ECE411PracticumTeam1/ECE411_PracticumProject_Team1/ECE411_Prototype/IMG_20221023_162744.jpg

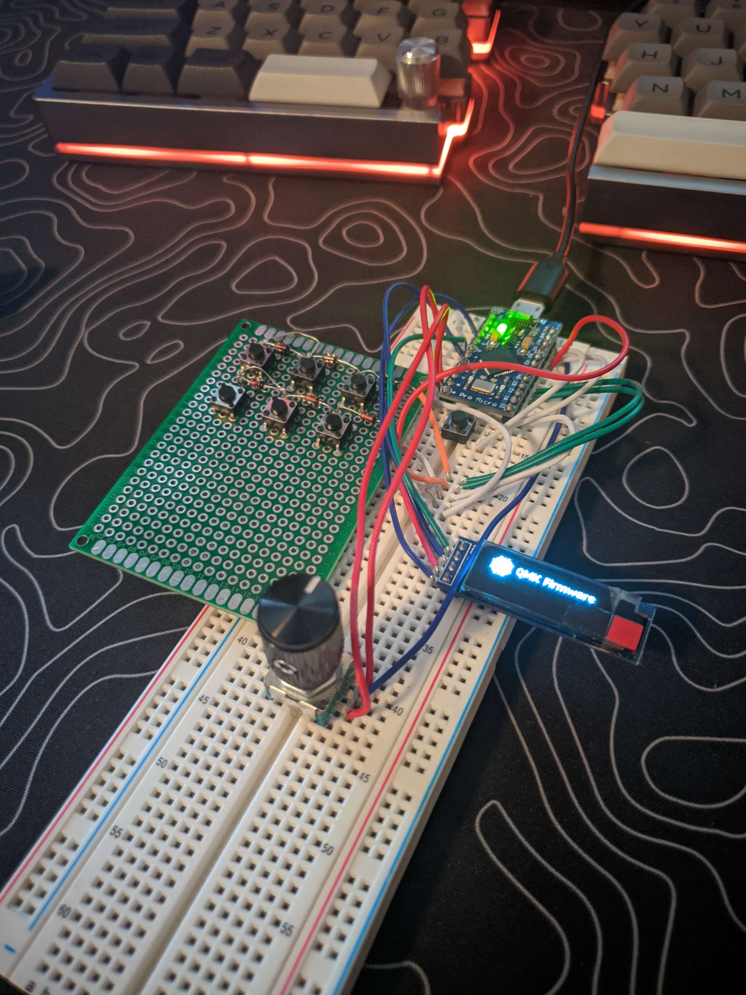
ECE411_Prototype/IMG_20221023_162744.jpg
