ECE411PracticumTeam1/ECE411_PracticumProject_Team1/README.md

# ECE411-Practicum Project
This is the repository for our programmable keyboard macropad. It houses all our schematics, case and pcb designs, code, and documentations.
