ECE411PracticumTeam1/ECE411_PracticumProject_Team1/Documents/Team1ProjSchedule.pdf

Team 1 Gannt Chart | Oct 31, 2022 http://

Project manager
Project dates | Oct 31, 2022 - Dec 10, 2022
Completion | 9%
Tasks | 14
Resources | 4

Name | Begin date | End date
Prototyping | 10/31/22 | 11/3/22
Schematic | 10/31/22 | 11/3/22
Preliminary Layout | 10/31/22 | 11/3/22
BOM | 11/4/22 | 11/10/22
CAD Rough Draft | 11/4/22 | 11/10/22
Functional Decomposition | 11/4/22 | 11/10/22
Finalize CAD | 11/4/22 | 11/15/22
Design Review Fix | 11/11/22 | 11/15/22
Send Board to Fab | 11/16/22 | 11/17/22
Design Housing | 11/17/22 | 11/23/22
Create Housing | 11/23/22 | 11/30/22
Testing | 12/1/22 | 12/8/22
Prepare Presentation/Demos | 12/1/22 | 12/8/22
Demo Day! | 12/9/22 | 12/9/22
Team 1 Gannt Chart | Oct 31, 2022
Tasks | 2

Name | Default role
David Dinh | developer
Johnathan Cruz | developer
Danny Tran | developer
David Brown | developer

## Resources

3

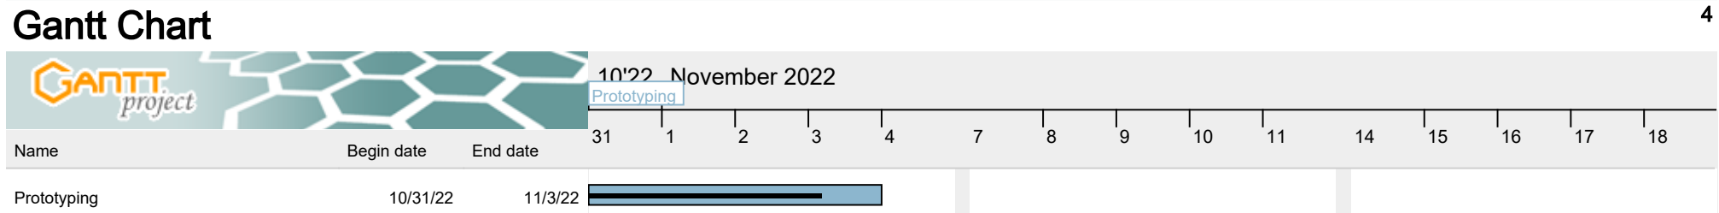
[picture p3: figure]
Gantt Chart; Name; Begin date; End date; Prototyping; 10'22 November 2022

Schematic | 10/31/22 | 11/3/22
Preliminary Layout | 10/31/22 | 11/3/22
BOM | 11/4/22 | 11/10/22
CAD Rough Draft | 11/4/22 | 11/10/22
Functional Decomposition | 11/4/22 | 11/10/22
Finalize CAD | 11/4/22 | 11/15/22
Design Review Fix | 11/11/22 | 11/15/22
Send Board to Fab | 11/16/22 | 11/17/22
Design Housing | 11/17/22 | 11/23/22
Create Housing | 11/23/22 | 11/30/22
Testing | 12/1/22 | 12/8/22
Prepare Presentation/Demos | 12/1/22 | 12/8/22
Demo Day! | 12/9/22 | 12/9/22
