ECE411PracticumTeam1/ECE411_PracticumProject_Team1/Documents/ECE411_Team_1_PDS/ECE411_Team_1_PDS-1.png

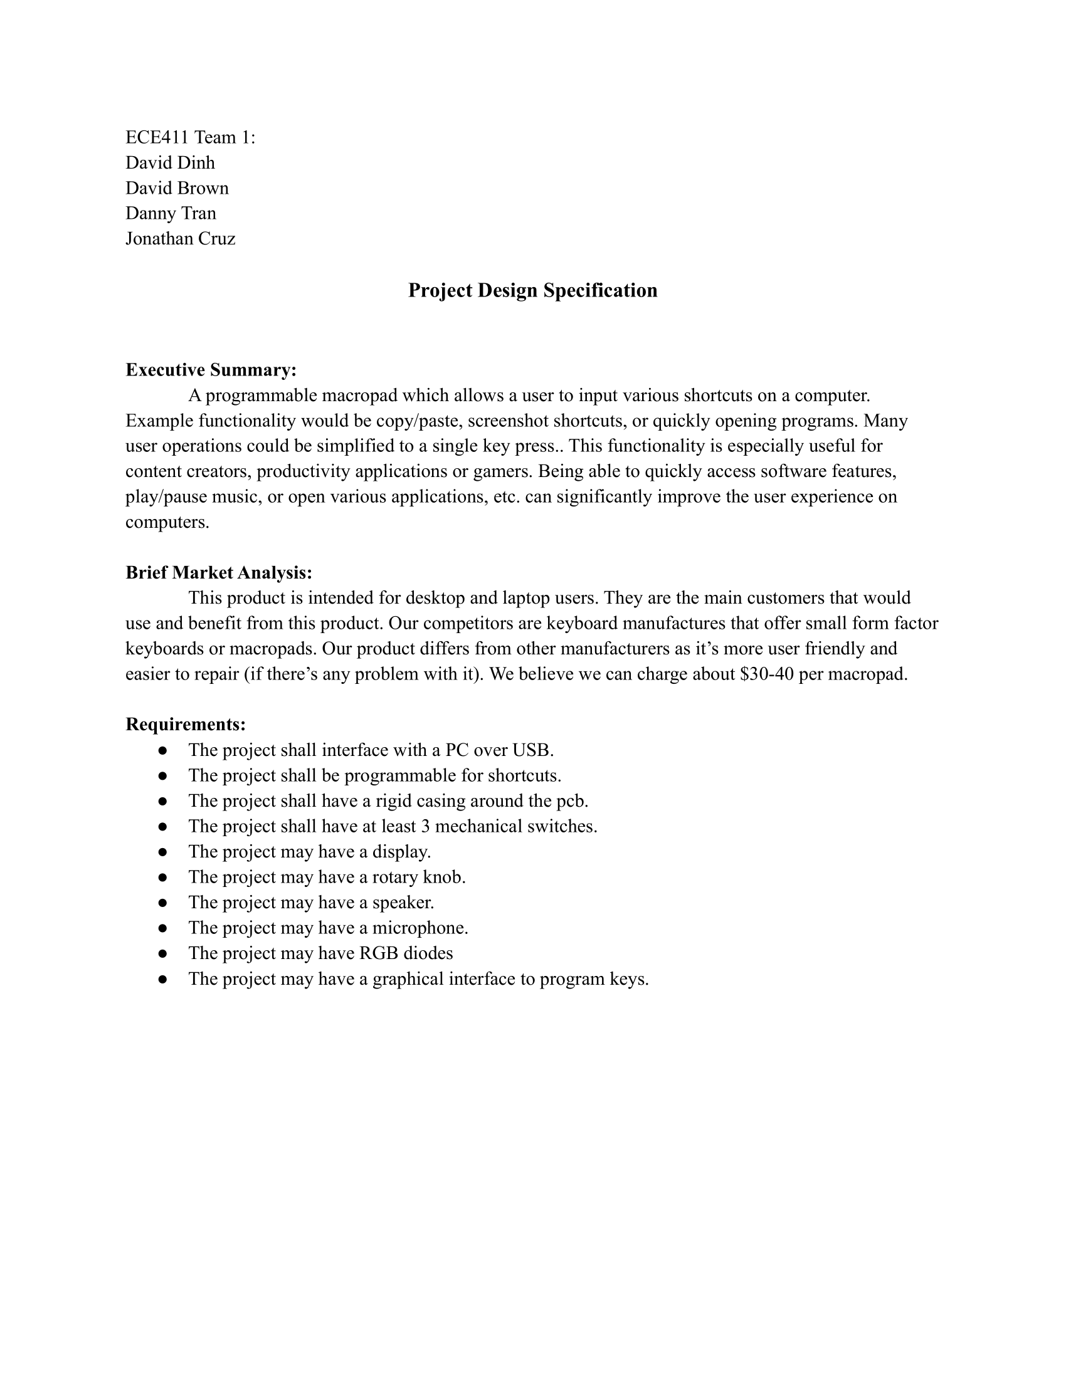
Documents/ECE411_Team_1_PDS/ECE411_Team_1_PDS-1.png
