ECE411PracticumTeam1/ECE411_PracticumProject_Team1/Functional_Decomposition/Functional Decomposition Level 0.png

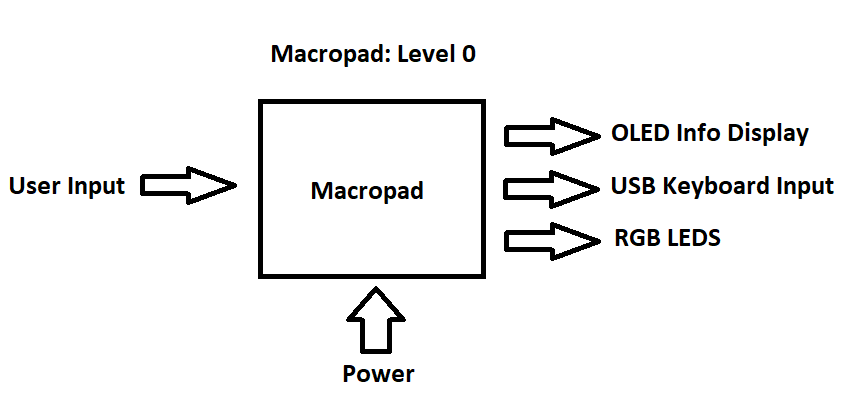
Functional_Decomposition/Functional Decomposition Level 0.png
