ECE411PracticumTeam1/ECE411_PracticumProject_Team1/Documents/Team_1_BOM.xlsx

Bill Of Materials for: [TEAM 1] [Team D3onathon]
Last modified: [11/9/2022]
PCB version: 1.0
BOM revision: A |  | P/NP | Place/Not Place (components marked NP are not stuffed on the board)
Count | Part References | P/NP | Mfg | Mfg PN | Description | Dist | Dist Part Number | Cost Ea. | Cost Total
30 | C1, C2, C3, C4, C5, C6 | P | KEMET | C0402C104K4PAC7867 | 0.1uF Ceramic Capacitor | Digikey (https://www.digikey.com/en/products/detail/kemet/C0402C104K4PAC7867/2196232) | 399-C0402C104K4PAC7867TR-ND | $0.10 | $3.00
100 | D1, D2, D3, D4, D5, D6 | P | Bridgold | bg-195 | DIODE | Amazon (https://www.amazon.com/Bridgold-1N4148W-High-Speed-Switching-SOD-123/dp/B09TKVYJL6) | B09TKVYJL6 | $0.08 | $8.00
20 | D7, D8, D9, D10, D11, D12 | P | DIYmall | WS2812B | LEDs | Amazon (https://www.amazon.com/DIYmall-WS2812B-Built-Programmable-Arduino/dp/B0B1MC997K) | B0B1MC997K | $0.40 | $8.00
5 | OL1 | P | Frienda | Frienda-d'Affichage-02 | OLED | Amazon (https://www.amazon.com/Pieces-Display-Module-SSD1306-3-3V-5V/dp/B08CDN5PSJ) | B08CDN5PSJ | $3.50 | $17.50
50 | R1 | P | YAGEO | RT0603FRE134K7L | 4.7k Chip Resistor | Digikey (https://www.digikey.com/en/products/detail/yageo/RT0603FRE134K7L/14286835) | 13-RT0603FRE134K7LTR-ND | $0.06 | $2.95
10 | SW1 | P | Omron Electronics Inc-EMC | B3F-1020 | RST Pin | Digikey (https://www.digikey.com/en/products/detail/omron-electronics-inc-emc-div/B3F-1020/44059) | SW402-ND | $0.38 | $3.80
70 | SW2, SW3, SW4, SW5, SW6, SW7 | P | N\C | N/A | SW_Push | Amazon (https://www.amazon.com/Gateron-Switches-%EF%BC%8CMechanical-Keyboard-Mechanical/dp/B09JSM1911) | B09JSM1911 | $0.34 | $23.80
1 | U1 | P | Sparkfun | DEV-12640 | Sparkfun_Pro_Micro | Sparkfun (https://www.sparkfun.com/products/12640) | DEV-12640 | $19.50 | $19.50
 |  |  |  |  |  |  |  | TOTAL: | $86.55
VERSION INFO
Rev | Date | Notes
A | 2022-11-09 | Intial BOM, with Rough Draft CAD
