ECE411PracticumTeam1/ECE411_PracticumProject_Team1/ECE411_Case/frameSplit.dxf

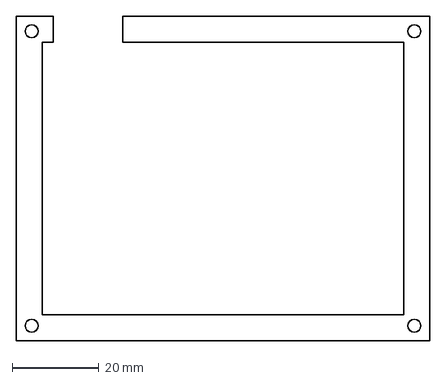
[picture p10: CAD file, 2022-12-08]
ECE411_Case/frameSplit.dxf
95.2 x 74.8 mm
