ECE411PracticumTeam1/ECE411_PracticumProject_Team1/ECE411_Case/backplate.dxf

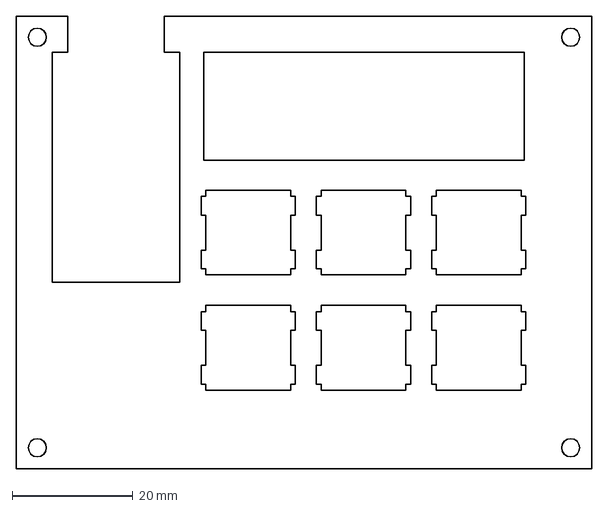
[picture p11: CAD file, 2022-12-08]
ECE411_Case/backplate.dxf
95.2 x 74.8 mm
