ECE411PracticumTeam1/ECE411_PracticumProject_Team1/Documents/Test_Plan_Team_1/Test_Plan_Team_1-1.png

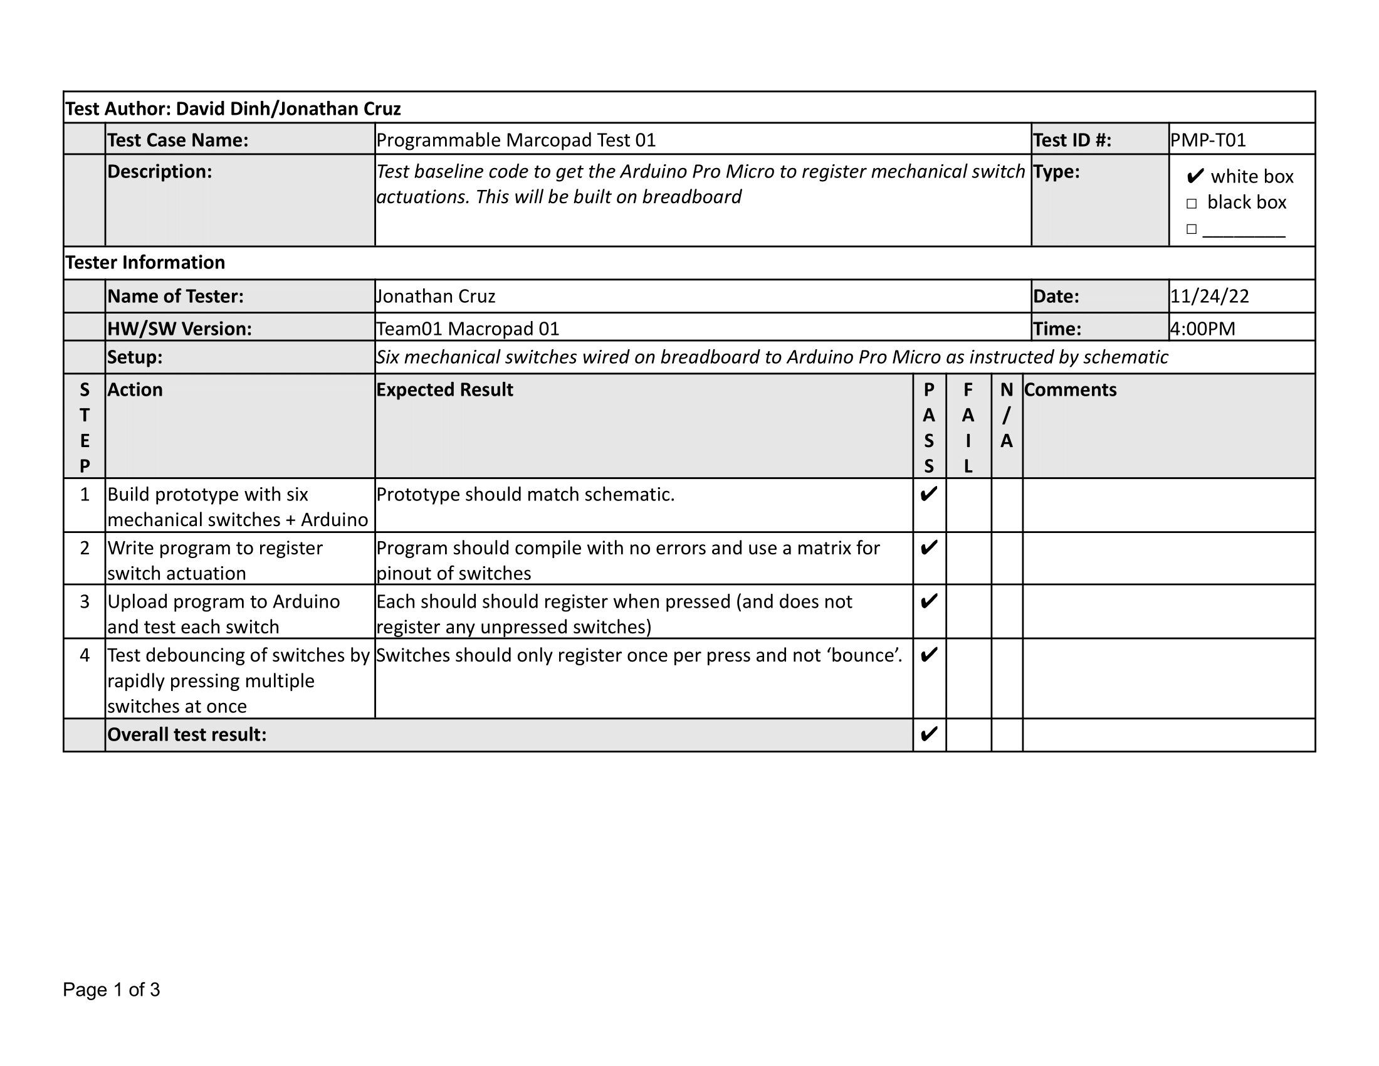
Documents/Test_Plan_Team_1/Test_Plan_Team_1-1.png
