ECE411PracticumTeam1/ECE411_PracticumProject_Team1/ECE411_Project Schematic/ECE411 Team 1 Practicum.pdf

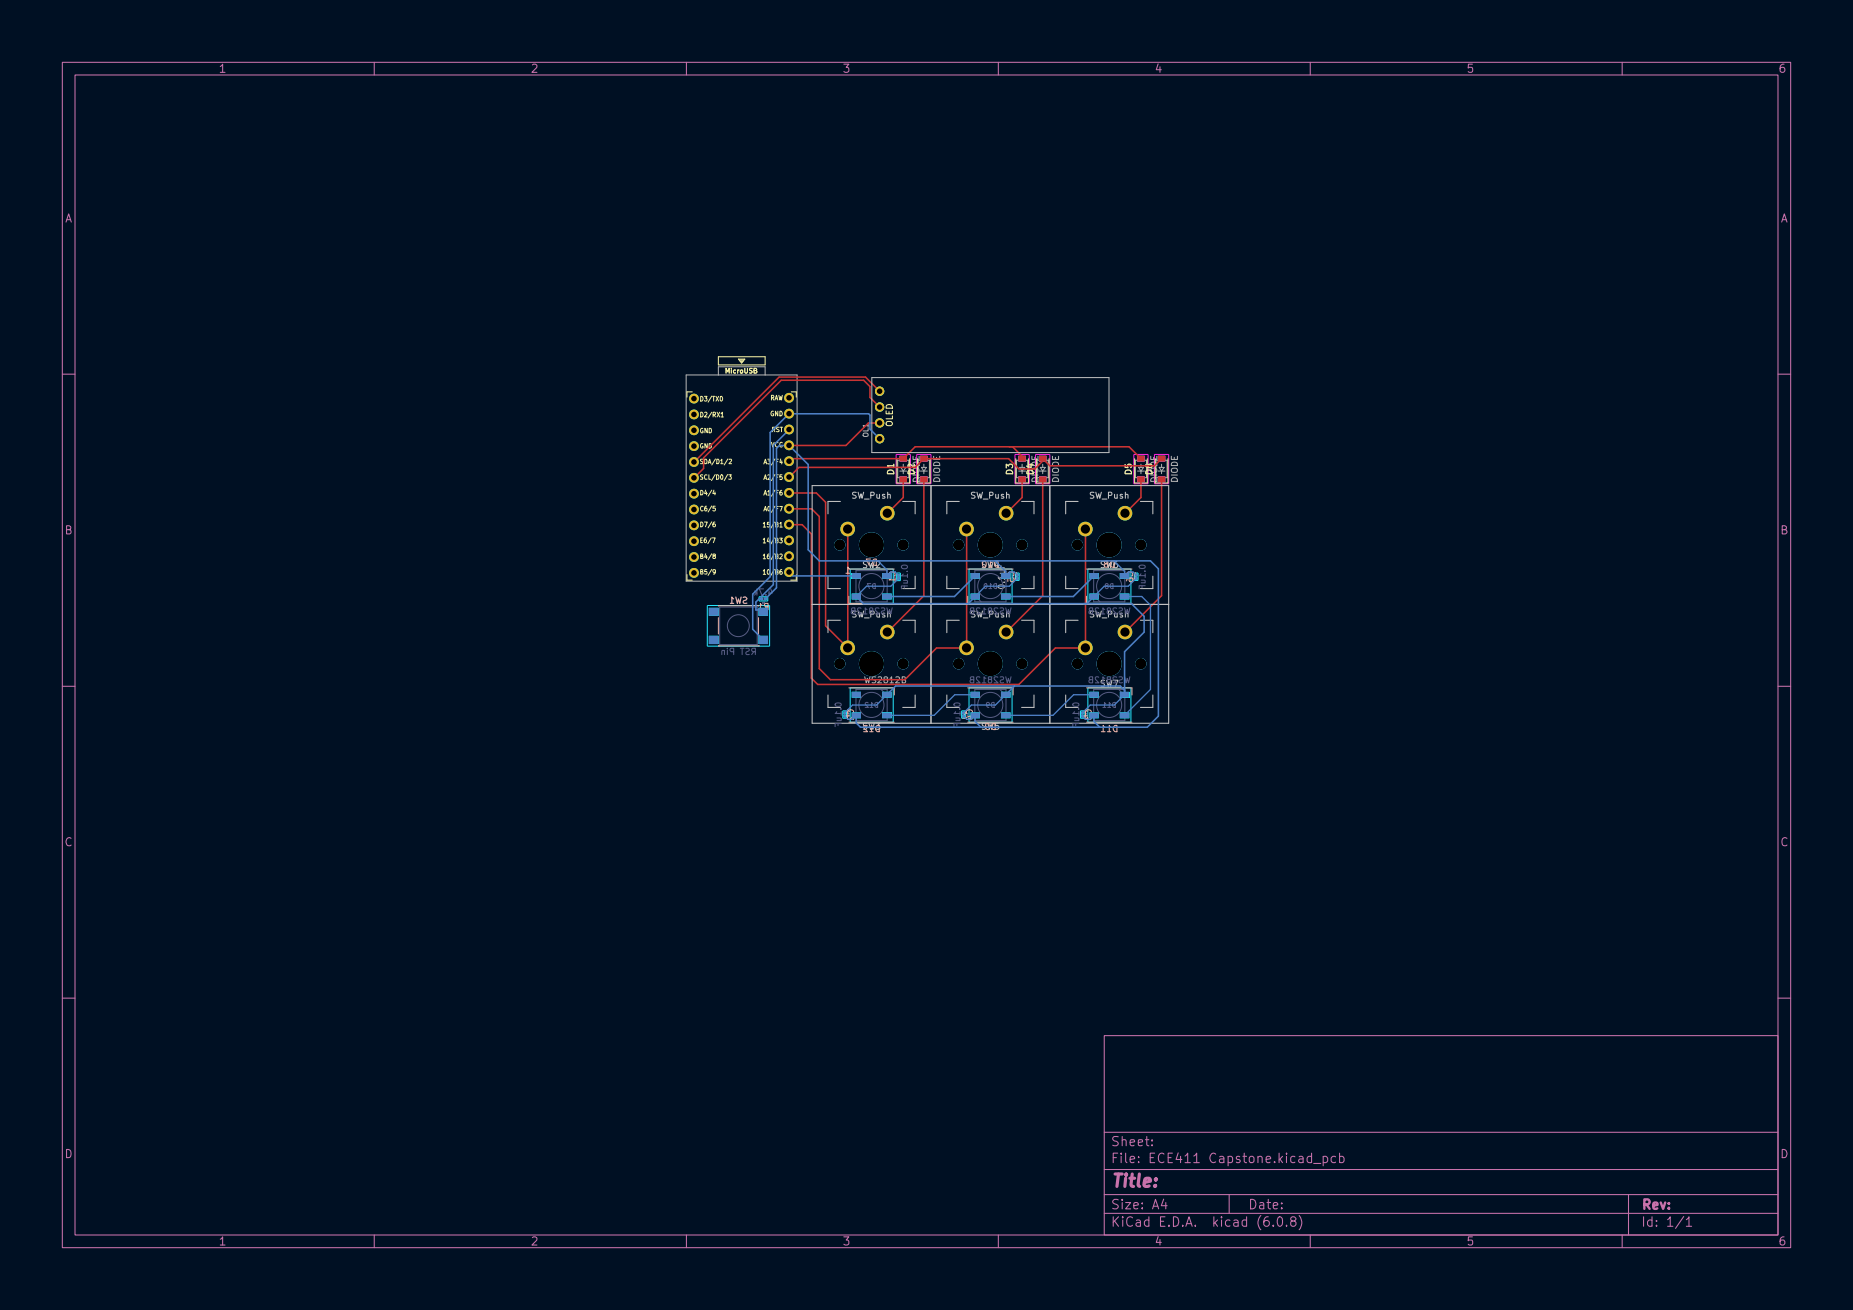
[picture p15: page 1]
