ECE411PracticumTeam1/ECE411_PracticumProject_Team1/ECE411_Project Schematic/ECE411_PracticumProject_Team1_PCB-1.pdf

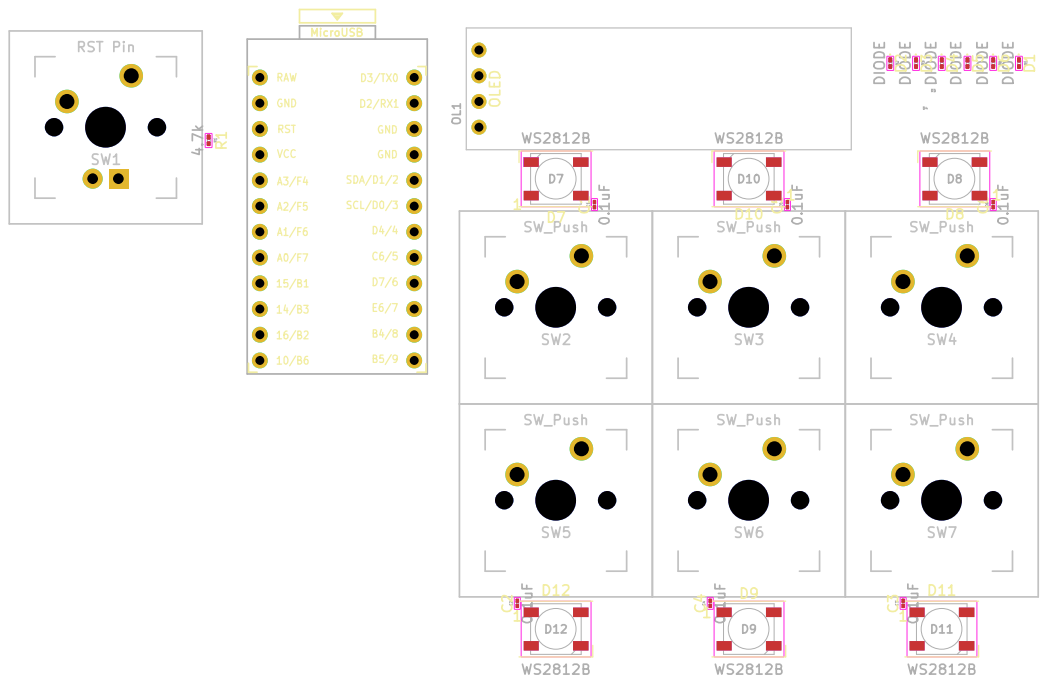
[picture p16: page 1]
