ECE411PracticumTeam1/ECE411_PracticumProject_Team1/ECE411_Project Schematic/ECE411_PracticumProject_Team1_Schematic-1.pdf

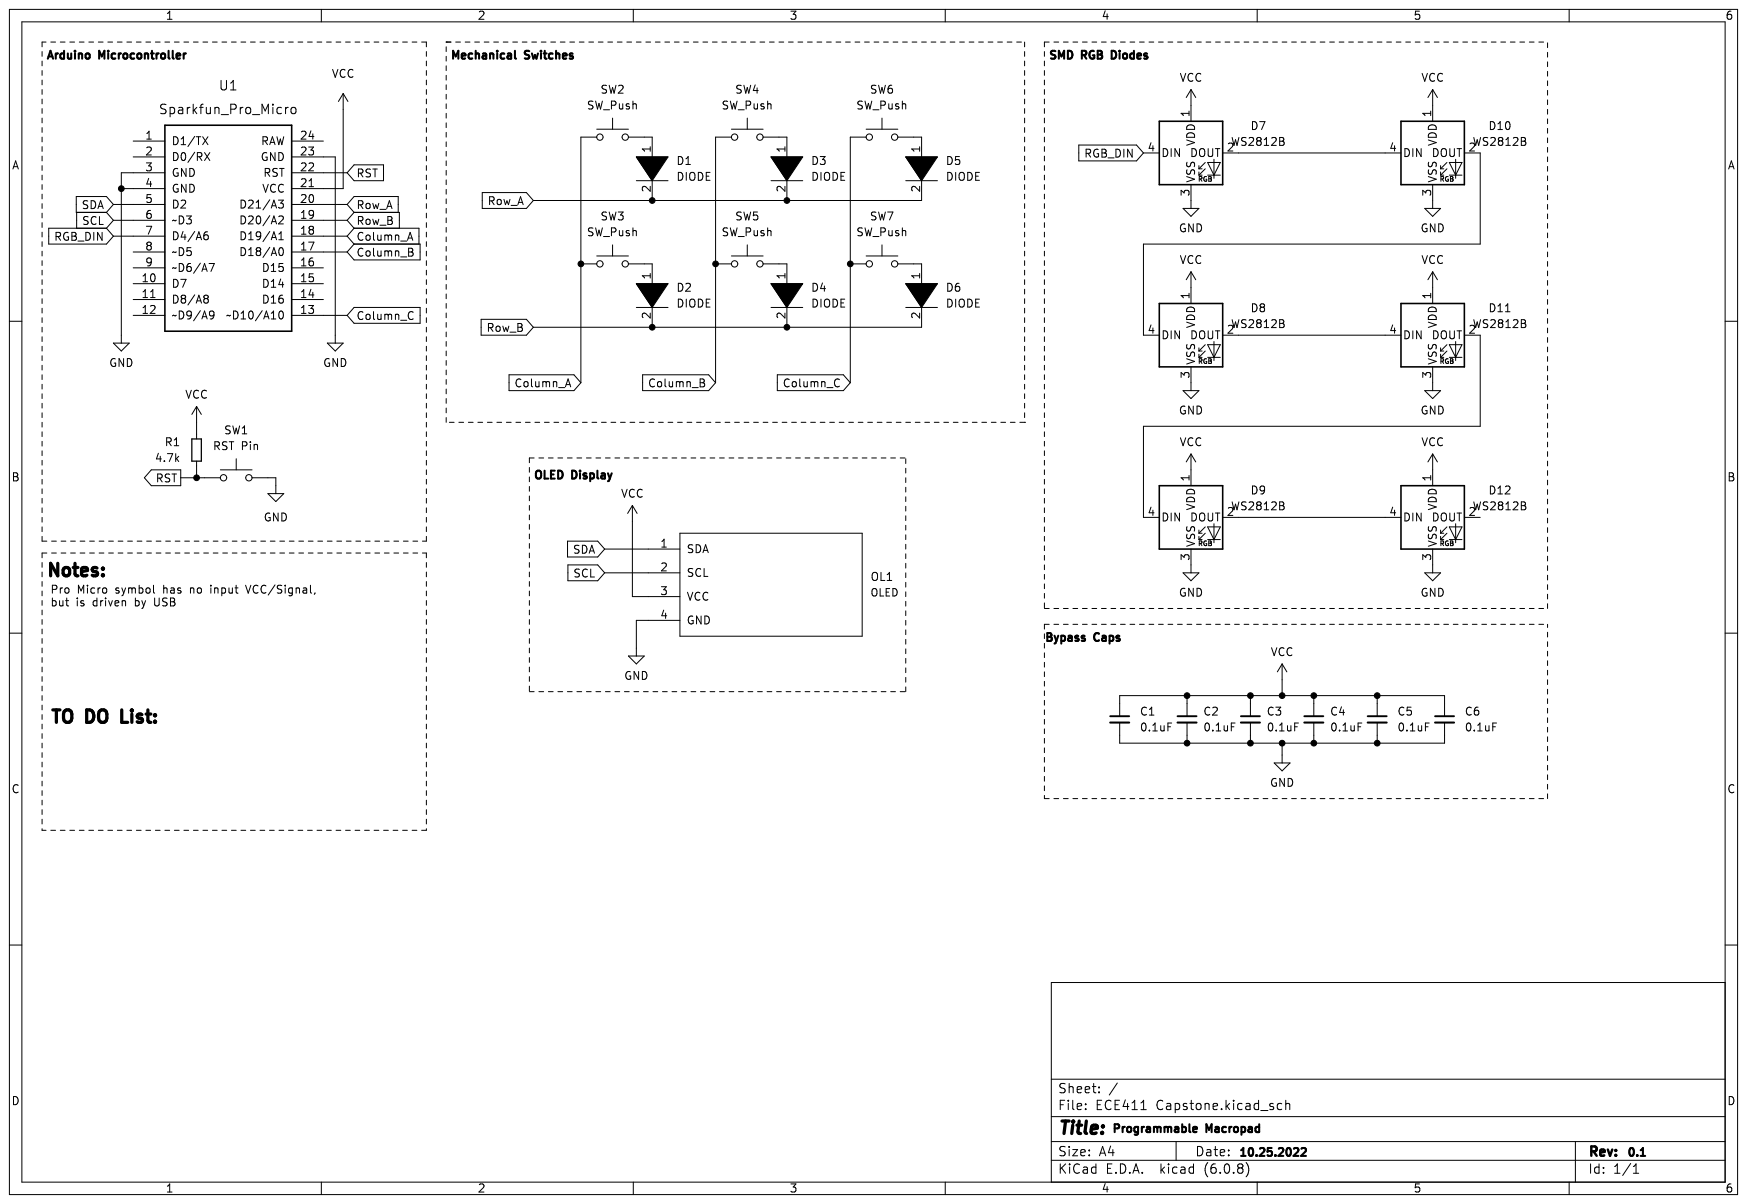
[picture p17: page 1]
