ECE411PracticumTeam1/ECE411_PracticumProject_Team1/ECE411_Layout/ECE411 Team 1 Schematic.pdf

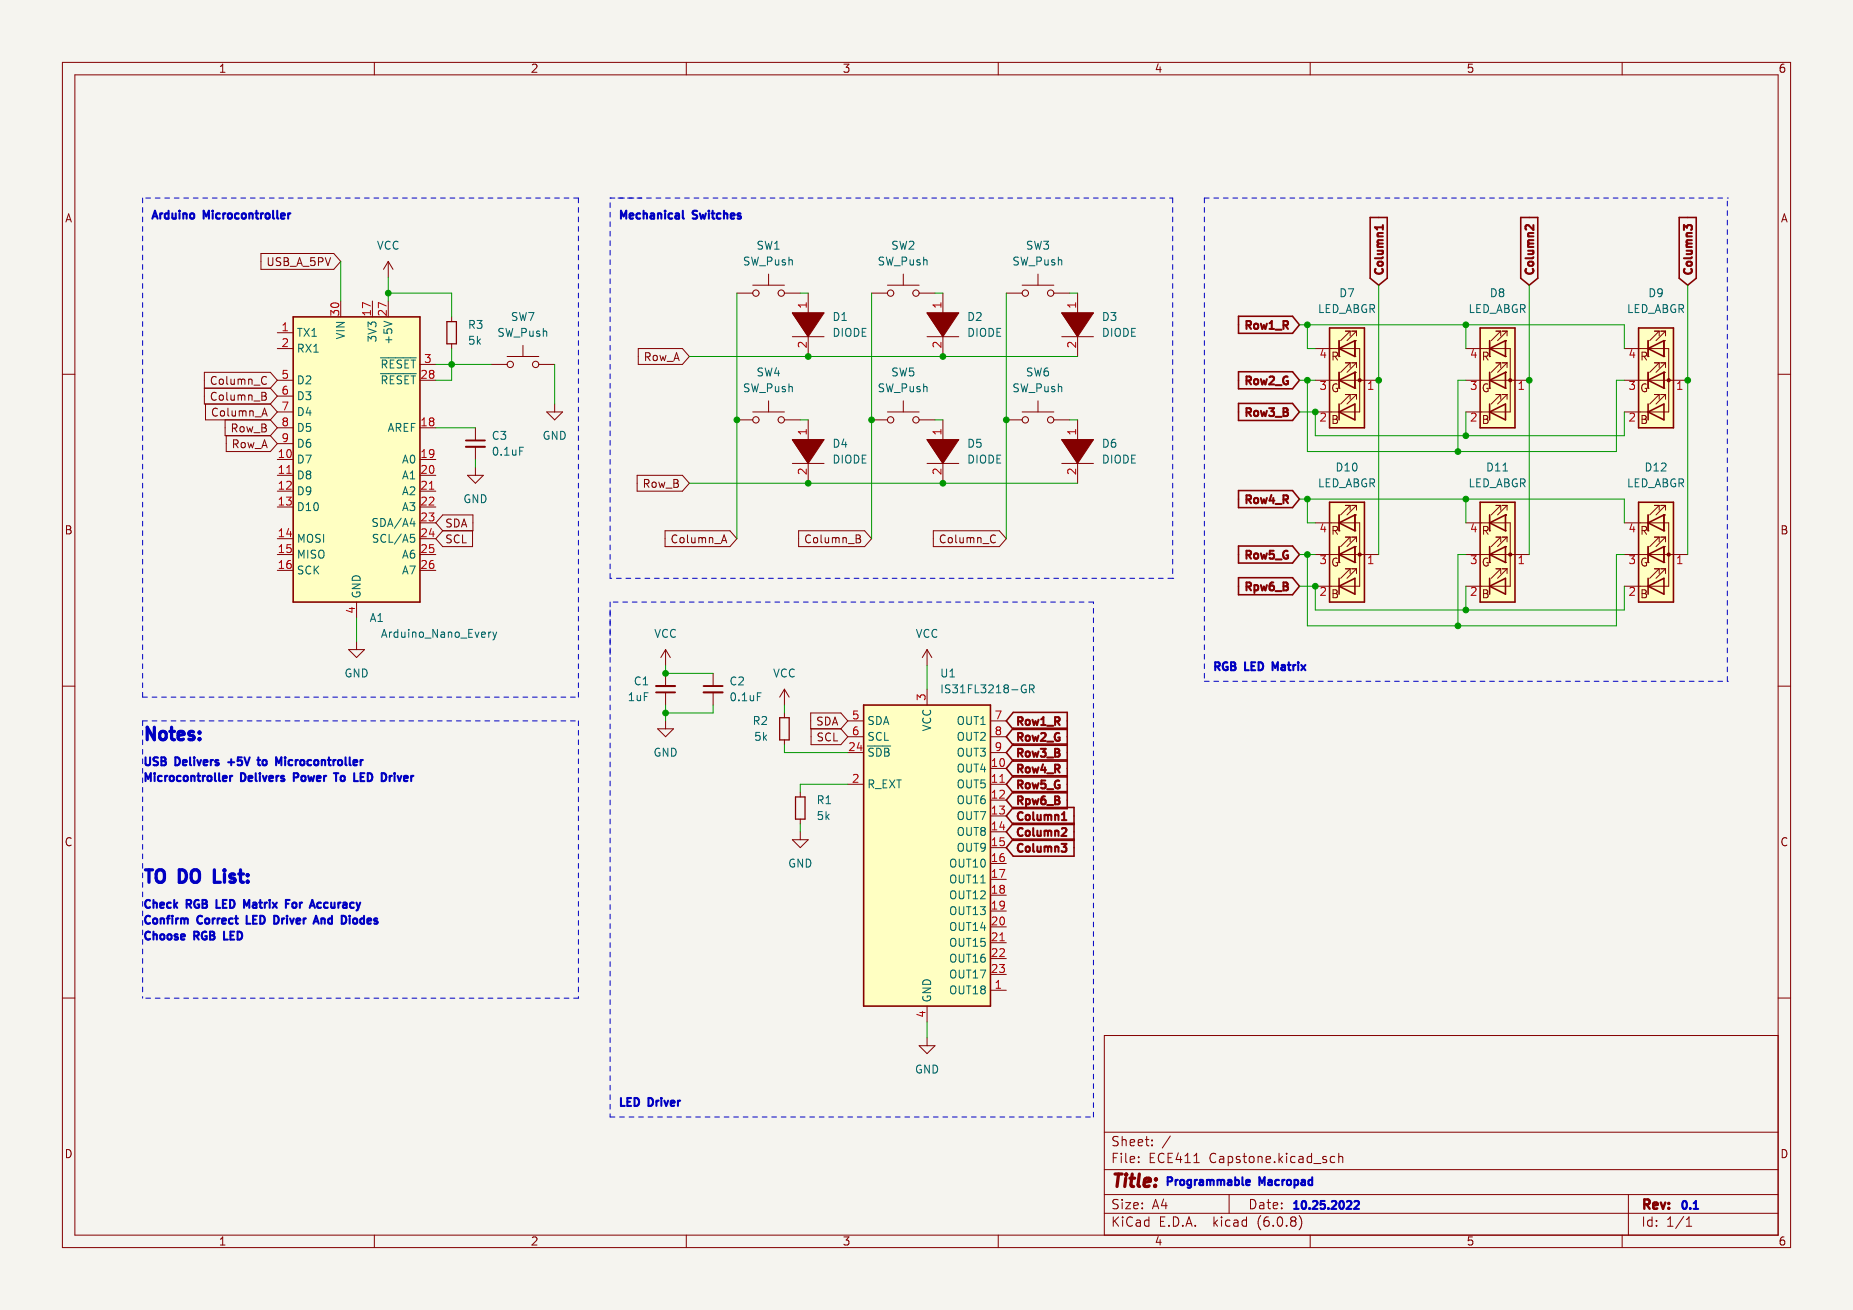
[picture p18: page 1]
