ECE411PracticumTeam1/ECE411_PracticumProject_Team1/ECE411_Layout/ECE411 Capstone.kicad_pcb

## KiCad design ECE411_Layout/ECE411 Capstone.kicad_pcb (2022-12-08)

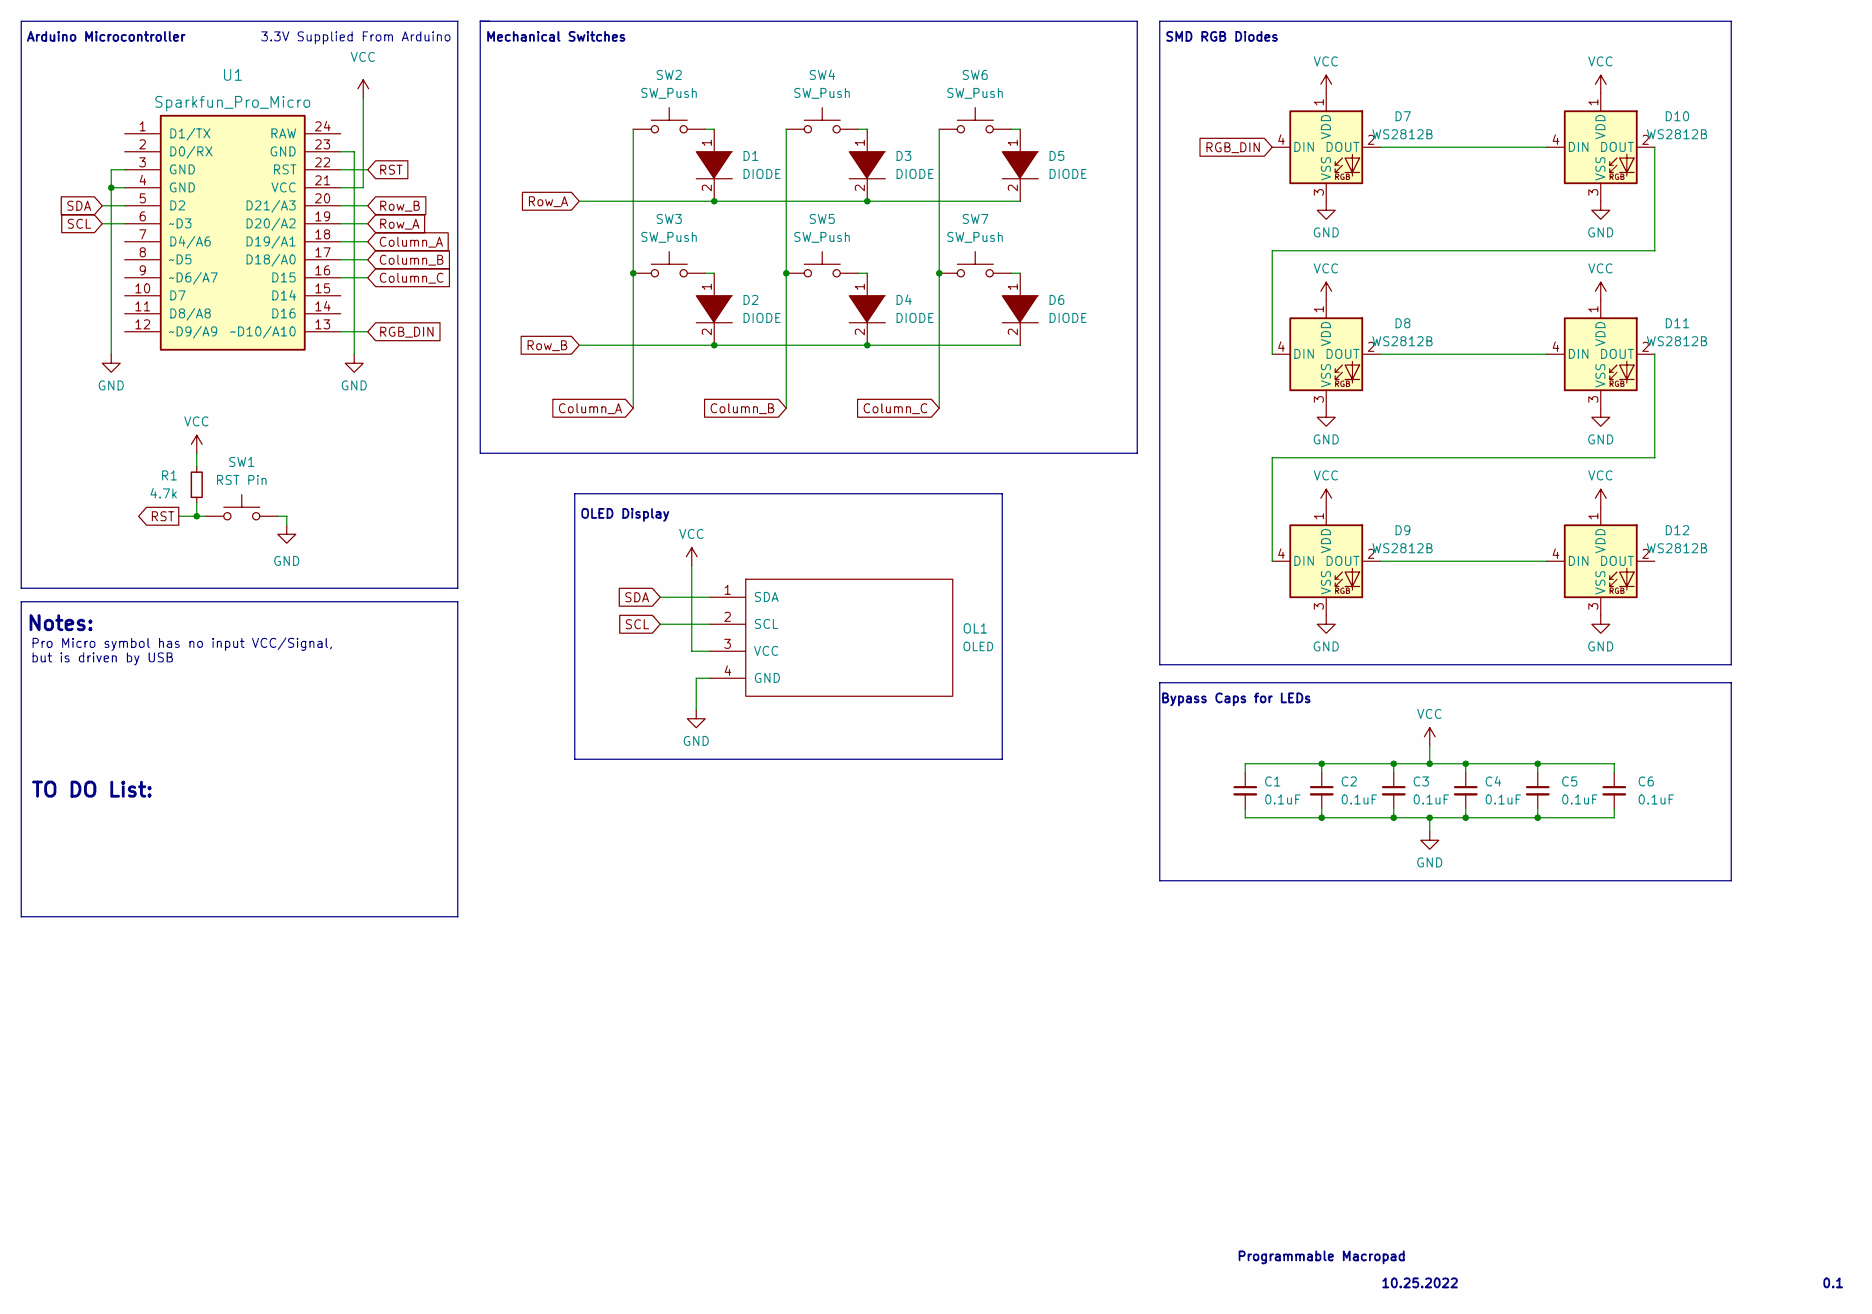
[picture p19: schematic ECE411 Capstone.kicad_sch]

Parts:
C1, C2, C3, C4, C5, C6: 0.1uF; C_0805_2012Metric
D1, D2, D3, D4, D5, D6: DIODE; D_SOD-123
D7, D8, D9, D10, D11, D12: WS2812B; LED_WS2812B_PLCC4_5.0x5.0mm_P3.2mm
OL1: OLED; OLED_v2
R1: 4.7k; R_0201_0603Metric
SW1: RST Pin; SW_Push_1P1T_NO_6x6mm_H9.5mm
SW2, SW3, SW4, SW5, SW6, SW7: SW_Push; MXOnly-1U-NoLED
U1: Sparkfun_Pro_Micro; ProMicro_v3

Connections:
Column_A: SW2.1, SW3.1, U1.18 (D19/A1)
Column_B: SW4.1, SW5.1, U1.17 (D18/A0)
Column_C: SW6.1, SW7.1, U1.16 (D15)
GND: C1.2, C2.2, C3.2, C4.2, C5.2, C6.2, D7.3 (VSS), D8.3 (VSS), D9.3 (VSS), D10.3 (VSS), D11.3 (VSS), D12.3 (VSS), OL1.4 (GND), SW1.2, U1.3 (GND), U1.4 (GND), U1.23 (GND)
unnamed: D1.1 (K), SW2.2
unnamed: D2.1 (K), SW3.2
unnamed: D3.1 (K), SW4.2
unnamed: D4.1 (K), SW5.2
unnamed: D5.1 (K), SW6.2
unnamed: D6.1 (K), SW7.2
unnamed: D8.4 (DIN), D10.2 (DOUT)
unnamed: D7.2 (DOUT), D10.4 (DIN)
unnamed: D9.4 (DIN), D11.2 (DOUT)
unnamed: D8.2 (DOUT), D11.4 (DIN)
unnamed: D9.2 (DOUT), D12.4 (DIN)
RGB_DIN: D7.4 (DIN), U1.13 (~D10/A10)
RST: R1.1, SW1.1, U1.22 (RST)
Row_A: D1.2 (A), D3.2 (A), D5.2 (A), U1.19 (D20/A2)
Row_B: D2.2 (A), D4.2 (A), D6.2 (A), U1.20 (D21/A3)
SCL: OL1.2 (SCL), U1.6 (~D3)
SDA: OL1.1 (SDA), U1.5 (D2)
VCC: C1.1, C2.1, C3.1, C4.1, C5.1, C6.1, D7.1 (VDD), D8.1 (VDD), D9.1 (VDD), D10.1 (VDD), D11.1 (VDD), D12.1 (VDD), OL1.3 (VCC), R1.2, U1.21 (VCC)

Notes on the sheet:
0.1
Mechanical Switches
OLED Display
3.3V Supplied From Arduino
10.25.2022
Arduino Microcontroller
Bypass Caps for LEDs
Notes:
TO DO List:
Programmable Macropad
Pro Micro symbol has no input VCC/Signal, but is driven by USB
SMD RGB Diodes

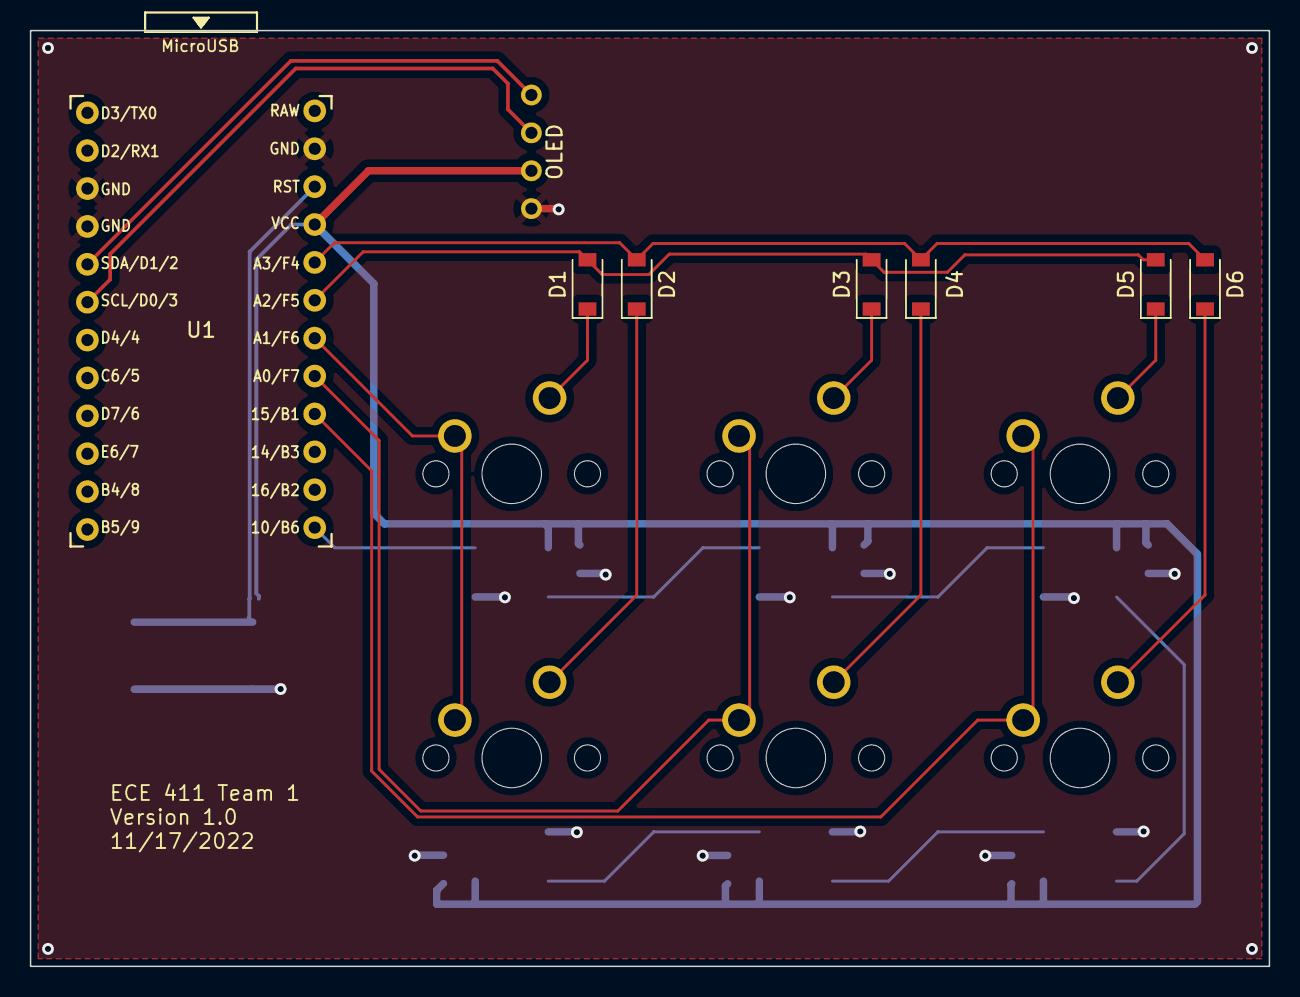
[picture p20: board ECE411 Capstone.kicad_pcb from above]

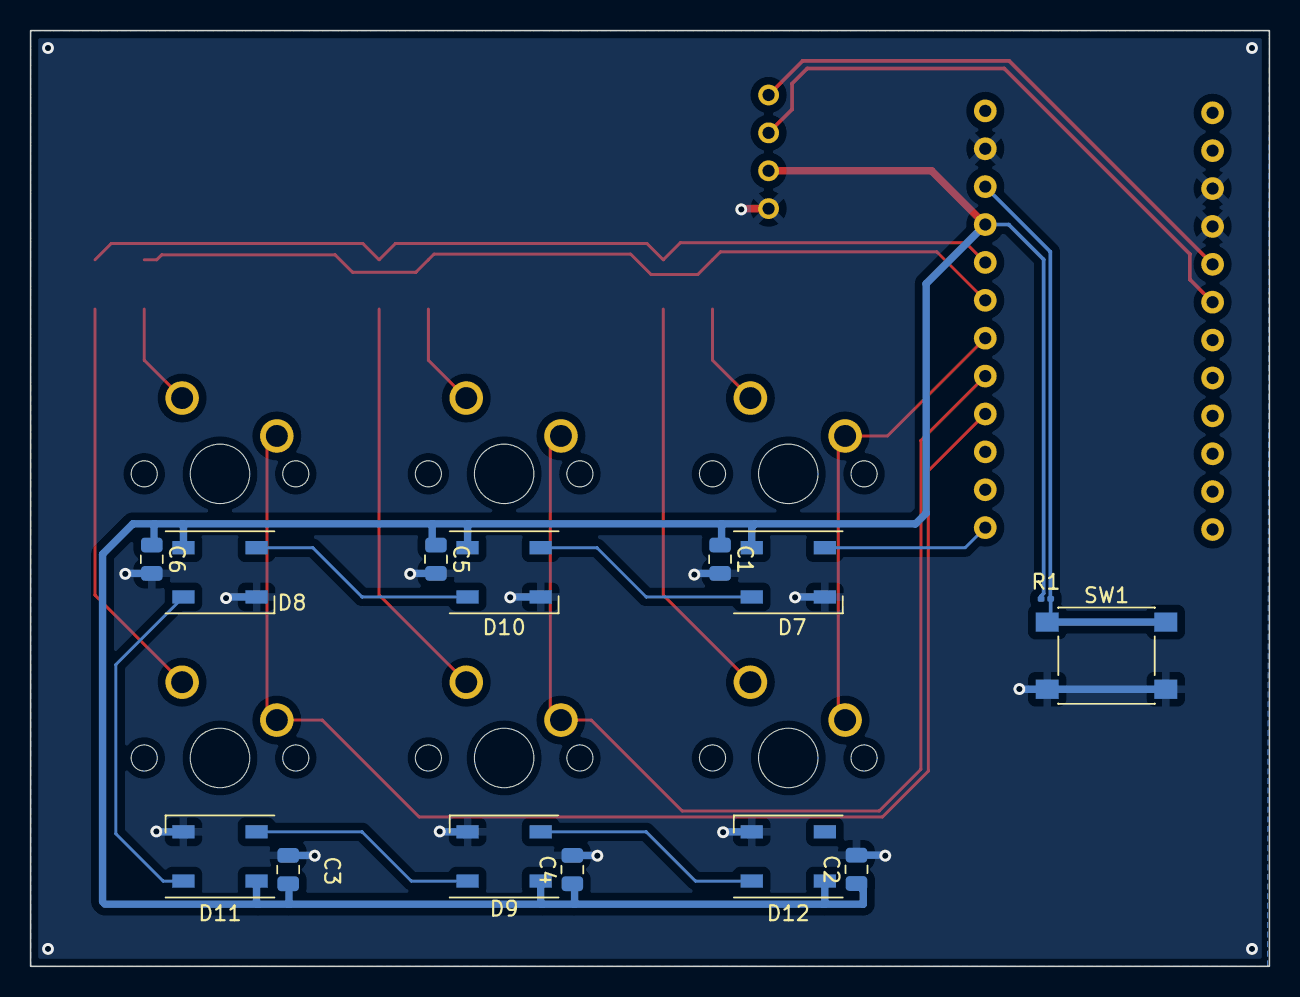
[picture p21: board ECE411 Capstone.kicad_pcb from below]

Board: 2 copper layers, 83.1 x 62.7 mm, 28 parts (14 on the bottom side), 22 nets.
