ECE411PracticumTeam1/ECE411_PracticumProject_Team1/(commit log)

2022-10-27 Project Schematic Ver.0.1
    [ECE411 Capstone.kicad_pcb, ECE411 Capstone.kicad_sch]
2022-10-27 Renamed schematic files
    [ECE411 Capstone.kicad_pcb, ECE411 Capstone.kicad_sch]
2022-10-27 Schematic Version 0.2
    [ECE411 Capstone.kicad_pcb, ECE411 Capstone.kicad_sch]
2022-11-01 Capstone Schematic + Initial PCB
    [ECE411 Capstone.kicad_pcb, ECE411 Capstone.kicad_sch]
2022-11-03 Functional Prototype
2022-11-03 Update Prototype Summary
2022-11-03 PCB + Schematic
2022-11-10 BOM
    Revision A
    [Team 1 BOM.xlsx]
2022-11-10 Updated PCB Layout + Routes
    [ECE411 Capstone.kicad_pcb]
2022-11-10 Removed unused files
    [ECE411 Capstone.kicad_pcb, ECE411 Capstone.kicad_sch]
2022-11-14 Updated Schematic + PCB for review
    [ECE411 Capstone.csv, ECE411 Capstone.kicad_pcb, ECE411 Capstone.kicad_sch]
2022-11-17 Final CAD layout
    [ECE411 Capstone.kicad_pcb, ECE411 Capstone.kicad_sch]
2022-12-01 Update for testing final version
    *Removed define for 128x64 OLED
    *Added defines for RGB LEDs
2022-12-01 Update for testing final board
    *Updated diode_direction to ROW2COL
    *Updated matrix pins
2022-12-01 Update for testing final board
    Enabled RGB LEDs
2022-12-08 Added & updated directories + updated names of files
    [ECE411 Capstone.csv, ECE411 Capstone.kicad_pcb, ECE411 Capstone.kicad_sch, Team_1_BOM.xlsx]
2022-12-08 Added case design files
    [backplate.dxf, base_trand.dxf, frameNoSplit_trand.dxf, frameSplit.dxf]
